sacy80/Helper-Fila-Sensor/README.md

Helper-Fila-Sensor are compatibe with most off the shelf 3d printer limit-switch filament sensor, it a helper that detect filament run out and sent a "PAUSE" http post request to mooraker. can be use on most klipper printer 

Take note: SMD and Throughole are 2 diff diemension board. Do not use the Case from SMD for Throughole. 

The micro controller used for this are Esp32-c6 super mini. check below link for the board infomation and where to get. :)
https://www.espboards.dev/esp32/esp32-c6-super-mini/

DIsplay - optional
Disply support - i2c or spi

For Diy limitswitch sensor:
switch model used - Omron D2FC-7
Switch size - 6.5mm X 12.8mm
screw - M1.4*10 - 4pc
Nut - M1.4 - 4pc

Case screw - M3*10 - 4pc
