sacy80/Helper-Fila-Sensor/Throughole/Readme

This is throughole compoment board. It desgin for easy solder. as the SMD version are using 0805 tiny componemt. it diemension are diff from the SMD compoment board. Do not use the case from the SMD , there are pcb stp for desgin .
