sacy80/Helper-Fila-Sensor/Throughole/BOM_Board1_Schematic1_2025-12-20.xlsx

No. | Quantity | Comment | Designator | Footprint | Value | Manufacturer Part | Manufacturer | Supplier Part | Supplier | LCSC Stock | LCSC Price | JLCPCB Stock | JLCPCB Price
1 | 4 | 100nF | C1,C2,C3,C4 | CAP-TH_L5.8-W2.4-P2.54-D0.6 | 100nF | CC1H104ZA1ED3F5P1100 | Dersonic(德尔创) | C2832506 | LCSC |  |  | 141450 | 0.002
2 | 2 | PM2.54-1*10 | H1,H2 | HDR-TH_10P-P2.54-V-F |  | PM2.54-1*10 | ZHOURI(洲日) | C5116489 | LCSC |  |  | 7431 | 0.0152
3 | 4 | 1kΩ | R1,R2,R3,R4 | RES-TH_BD2.4-L6.3-P10.30-D0.6 | 1kΩ | MFR-25FTE52-1K | YAGEO(国巨) | C172978 | LCSC |  |  | 21897 | 0.0017
4 | 1 | SPOOL0 | U1 | CONN-TH_XHB-3AW |  | XHB-3AW | BOOMELE(博穆精密) | C95477 | LCSC |  |  | 23767 | 0.0031
5 | 1 | SPOOL1 | U2 | CONN-TH_XHB-3AW |  | XHB-3AW | BOOMELE(博穆精密) | C95477 | LCSC |  |  | 23767 | 0.0031
6 | 1 | SPOOL2 | U3 | CONN-TH_XHB-3AW |  | XHB-3AW | BOOMELE(博穆精密) | C95477 | LCSC |  |  | 23767 | 0.0031
7 | 1 | SPOOL3 | U4 | CONN-TH_XHB-3AW |  | XHB-3AW | BOOMELE(博穆精密) | C95477 | LCSC |  |  | 23767 | 0.0031
8 | 1 | I2C/SPI LCD | U5 | HDR-TH_7P-P2.54-V-F |  | PM2.54-1*7 | ZHOURI(洲日) | C5371993 | LCSC |  |  | 4885 | 0.0138
