sacy80/Helper-Fila-Sensor/SMD/PCB_Case/Helper_Fila_Sensor_SMD_Case_Part1.step

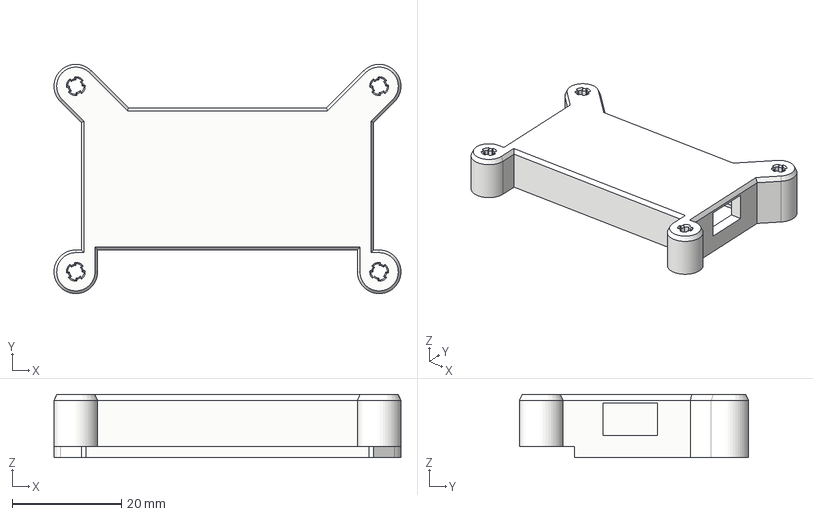
[picture p1: CAD file, 2025-12-19]
SMD/PCB_Case/Helper_Fila_Sensor_SMD_Case_Part1.step
63.6 x 42.0 x 11.6 mm
