sacy80/Helper-Fila-Sensor/Throughole/Cable Clip/Helper_Fila_SensorCable_Clip.stl

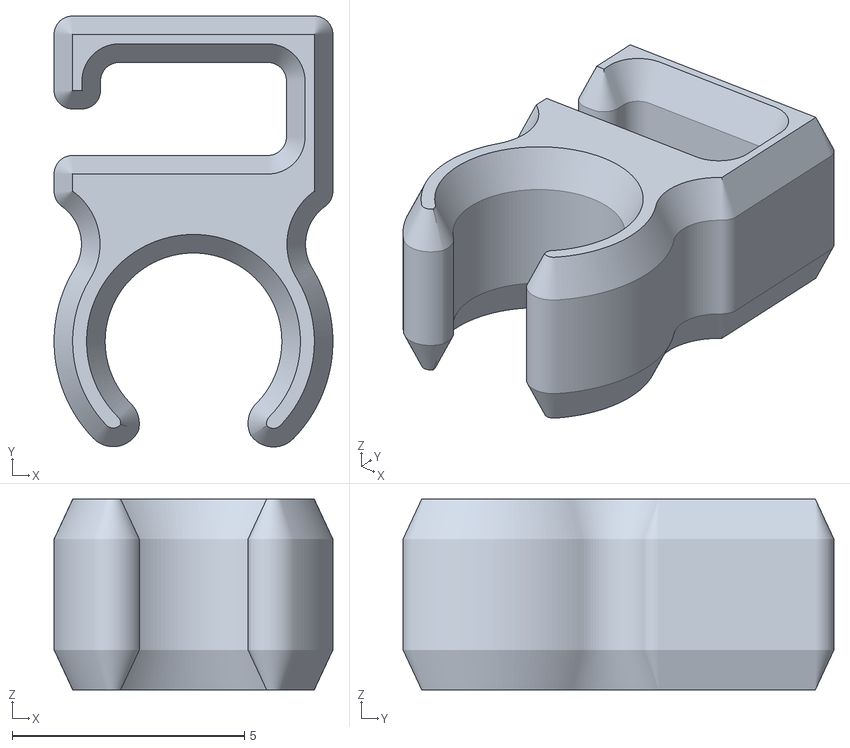
[picture p2: CAD file, 2025-12-19]
Throughole/Cable Clip/Helper_Fila_SensorCable_Clip.stl
6.00 x 9.27 x 4.10
