sacy80/Helper-Fila-Sensor/Throughole/Sensor_Case/Helper_Fila_Sensor_SMD_Sensor_Case_Part2.step

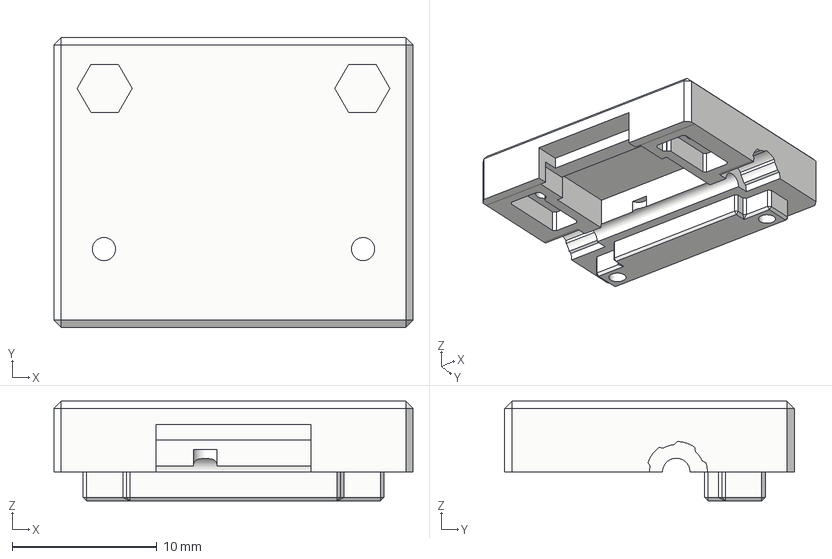
[picture p3: CAD file, 2025-12-19]
Throughole/Sensor_Case/Helper_Fila_Sensor_SMD_Sensor_Case_Part2.step
24.8 x 20.0 x 6.90 mm
