sacy80/Helper-Fila-Sensor/SMD/PCB_Case/Helper_Fila_Sensor_SMD_Case_Part2.step

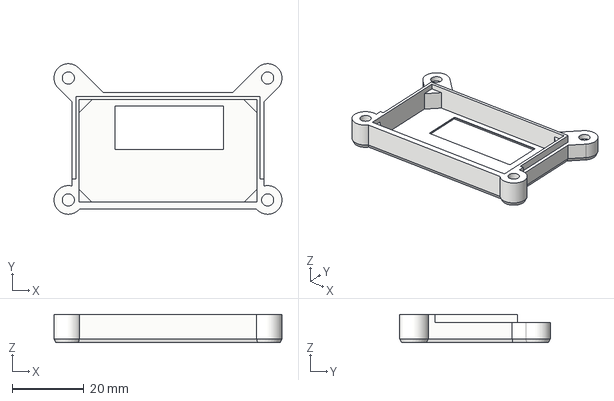
[picture p4: CAD file, 2025-12-19]
SMD/PCB_Case/Helper_Fila_Sensor_SMD_Case_Part2.step
63.6 x 42.0 x 7.87 mm
