sacy80/Helper-Fila-Sensor/(list of files, cad)

Other CAD files:
Throughole/Sensor_Case/Helper_Fila_Sensor_SMD_Sensor_case_part1.step
