sacy80/Helper-Fila-Sensor/SMD/SCH_External_Fila_Sensor_Chroma_2025-12-20.pdf

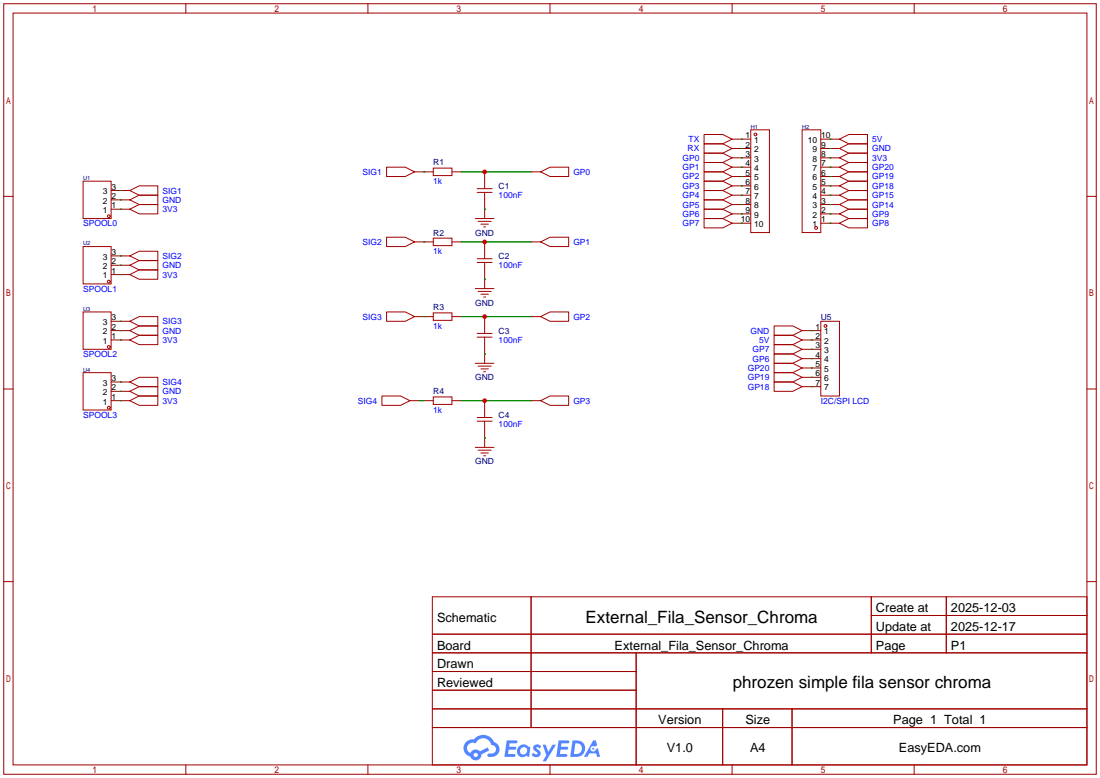
[picture p5: page 1]

Schematic | External_Fila_Sensor_Chroma | Create at | 2025-12-03

Update at | 2025-12-17

Board | External_Fila_Sensor_Chroma | Page | P1
Drawn | | phrozen simple fila sensor chroma
Reviewed

Version | Size | Page 1 Total 1
V1.0 | A4 | EasyEDA.com
