sacy80/Helper-Fila-Sensor/Throughole/PCB_PCB1_Helper_Fila_Sensor_TH.pdf

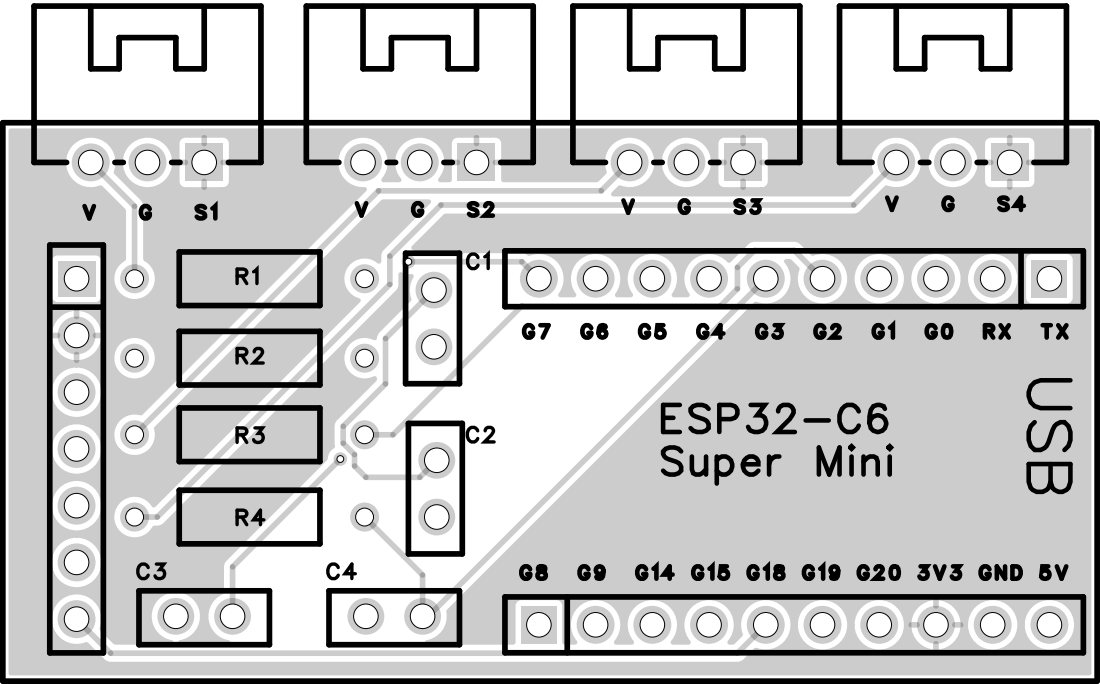
[picture p6: page 1]

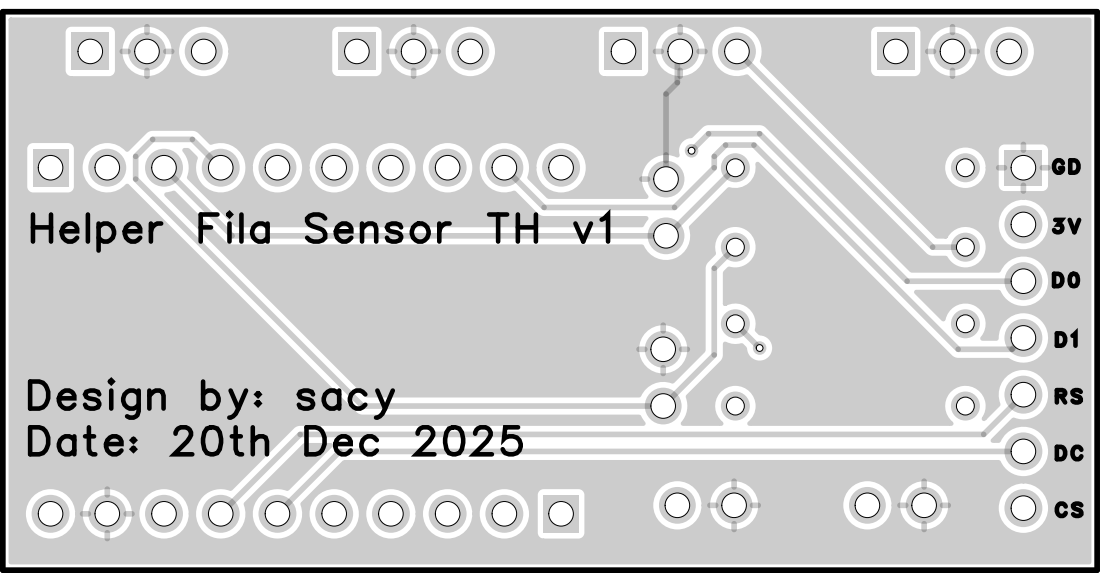
[picture p7: page 2]

Helper Fila Sensor TH v1

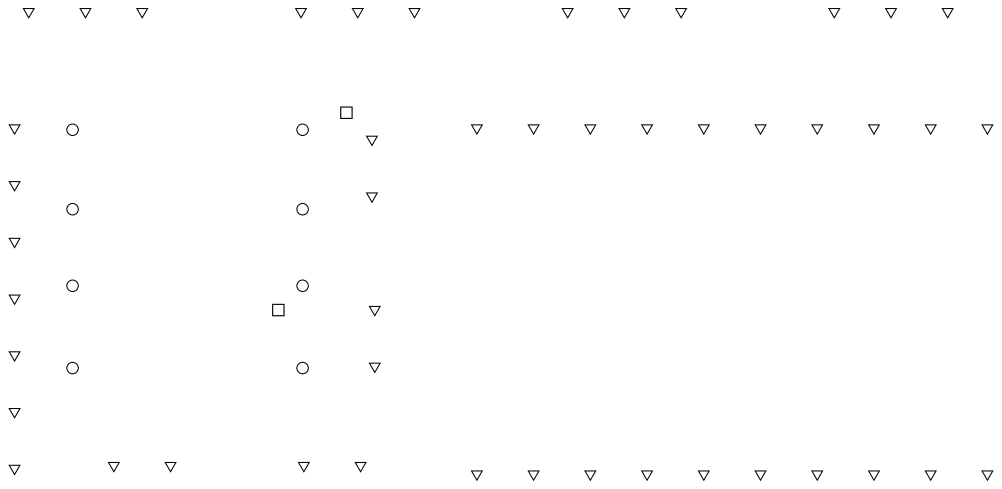
[picture p8: page 3]
